XianYuFDK/STM32F407_Puzzle_Arm/硬件接线表.md

# STM32F407VGT6机械臂工程接线表

本文档依据当前工程 `D:\STM32\HAL\26` 的实际代码和 `26.ioc` 整理。

## 一、总引脚表

| 模块 | 功能 | STM32外设 | STM32引脚 | 有效方式/说明 |
|---|---|---|---|---|
| 舵机1 | 电磁铁末端旋转J1 | TIM1_CH2 | PE11 | 50Hz PWM，500~2500us对应0~180度 |
| 舵机2 | 腕部俯仰J2 | TIM1_CH3 | PE13 | 50Hz PWM，500~2500us对应0~180度 |
| 舵机3 | 肘部J3 | TIM1_CH4 | PE14 | 50Hz PWM，500~2500us对应0~180度 |
| 舵机4 | 肩部J4 | TIM8_CH1 | PC6 | 50Hz PWM，500~2500us对应0~180度 |
| 舵机5 | 底座旋转J5 | TIM8_CH2 | PC7 | 50Hz PWM，500~2500us对应0~180度 |
| K230视觉TX | STM32向视觉发送3A/3B/3C/AC等 | USART1_TX | PB6 | 115200，8N1，3.3V TTL |
| K230视觉RX | STM32接收52字节视觉帧 | USART1_RX | PB7 | DMA+空闲中断，3.3V TTL |
| 电脑调试TX | STM32向USB-TTL输出文本 | USART2_TX | PA2 | 115200，8N1，3.3V TTL |
| 电脑调试RX | STM32接收电脑文本命令 | USART2_RX | PA3 | DMA+空闲中断，3.3V TTL |
| 电磁铁继电器 | 控制电磁铁通断 | GPIO输出 | PD12 | 高电平闭合继电器 |
| 完成蜂鸣器 | 拼图完成提示 | GPIO输出 | PE9 | 高电平触发，响300ms后拉低 |
| 急停输入 | 常闭急停开关 | GPIO输入 | PD13 | 低电平有效；当前软件配置为关闭 |
| 按键1 | 启动任务1 | GPIO输入 | PE0 | 内部上拉，按下接GND |
| 按键2 | 启动任务2 | GPIO输入 | PE1 | 内部上拉，按下接GND |
| 按键3 | 启动任务3 | GPIO输入 | PE2 | 内部上拉，按下接GND |
| 按键4 | GOTO原点测试 | GPIO输入 | PE3 | 内部上拉，按下接GND |
| 按键5 | GOTO远点测试 | GPIO输入 | PE4 | 内部上拉，按下接GND |
| 按键6 | GOTO负Y测试点 | GPIO输入 | PE5 | 内部上拉，按下接GND |
| 按键7 | HOME | GPIO输入 | PE6 | 内部上拉，按下接GND |
| 按键8 | 软件强制停止 | GPIO输入 | PE7 | 内部上拉，按下接GND |
| 按键9 | 视觉校准 | GPIO输入 | PE8 | 内部上拉，按下接GND |
| 按键10 | 视觉辅助校准 | GPIO输入 | PE10 | 内部上拉，按下接GND |

## 二、5路舵机接线

| 新编号 | 机械作用 | PWM信号线 | 电源线 | 地线 |
|---|---|---|---|---|
| J1/舵机1 | 电磁铁末端旋转 | PE11 | 外部舵机电源正极 | 外部电源GND及STM32 GND |
| J2/舵机2 | 腕部俯仰 | PE13 | 外部舵机电源正极 | 外部电源GND及STM32 GND |
| J3/舵机3 | 肘部 | PE14 | 外部舵机电源正极 | 外部电源GND及STM32 GND |
| J4/舵机4 | 肩部 | PC6 | 外部舵机电源正极 | 外部电源GND及STM32 GND |
| J5/舵机5 | 底座旋转 | PC7 | 外部舵机电源正极 | 外部电源GND及STM32 GND |

舵机必须使用足够电流的独立电源，不能由STM32开发板的3.3V或小电流5V引脚直接供电。舵机电源GND、STM32 GND、K230 GND和USB-TTL GND必须共地。

## 三、K230视觉串口接线

| STM32端 | 连接K230端 |
|---|---|
| PB6 / USART1_TX | K230 RX |
| PB7 / USART1_RX | K230 TX |
| STM32 GND | K230 GND |

串口参数为115200、8位数据位、无校验、1位停止位、无硬件流控。TX与RX必须交叉连接。不要把5V串口电平直接接入STM32或K230。

## 四、电脑USB-TTL调试串口

| STM32端 | 连接USB-TTL端 |
|---|---|
| PA2 / USART2_TX | USB-TTL RX |
| PA3 / USART2_RX | USB-TTL TX |
| STM32 GND | USB-TTL GND |

USB-TTL应选择3.3V TTL逻辑电平，参数为115200、8N1。该串口使用ASCII文本命令。

## 五、按键接线和功能

所有按键采用内部上拉、低电平触发。每个按键一端连接对应GPIO，另一端连接GND，不需要外接3.3V。

| 按键 | GPIO | 当前功能 |
|---|---|---|
| KEY1 | PE0 | 启动任务1，向视觉发送0x3A |
| KEY2 | PE1 | 启动任务2，向视觉发送0x3B |
| KEY3 | PE2 | 启动任务3，向视觉发送0x3C，使用任务3独立速度参数 |
| KEY4 | PE3 | `GOTO 0 0 5 0 2000` |
| KEY5 | PE4 | `GOTO 210 0 5 0 3000` |
| KEY6 | PE5 | `GOTO 105 -70 1 0 3000` |
| KEY7 | PE6 | 3000ms回HOME |
| KEY8 | PE7 | 停止拼图、校准和运动，并关闭电磁铁 |
| KEY9 | PE8 | 向视觉发送0x3F，启动视觉校准 |
| KEY10 | PE10 | 向视觉发送0xAD，启动视觉辅助校准 |

接线示意：

```text
PE0  ---- KEY1  ---- GND
PE1  ---- KEY2  ---- GND
PE2  ---- KEY3  ---- GND
PE3  ---- KEY4  ---- GND
PE4  ---- KEY5  ---- GND
PE5  ---- KEY6  ---- GND
PE6  ---- KEY7  ---- GND
PE7  ---- KEY8  ---- GND
PE8  ---- KEY9  ---- GND
PE10 ---- KEY10 ---- GND
```

四脚轻触按键同一侧两个引脚通常内部相连，应从按键相对的两侧分别接GPIO和GND。

## 六、电磁铁继电器接线

控制端：

| STM32端 | 继电器模块端 |
|---|---|
| PD12 | IN/信号输入 |
| STM32 GND | 继电器模块GND |
| 模块要求的电源 | 继电器模块VCC |

负载端常用接法：

```text
电磁铁电源正极 ---- 继电器COM
继电器NO       ---- 电磁铁正极
电磁铁负极     ---- 电磁铁电源负极
```

PD12输出高电平时继电器闭合。若使用裸继电器，必须增加三极管/MOSFET驱动和续流二极管；不要由PD12直接驱动继电器线圈。

## 七、拼图完成蜂鸣器

| STM32端 | 高电平触发有源蜂鸣器模块 |
|---|---|
| PE9 | IN/信号输入 |
| STM32 GND | GND |
| 模块要求的电源 | VCC |

最后一块拼图放下并关闭电磁铁后，程序等待 `ARM_PUZZLE_DONE_DELAY_MS`，随后PE9输出高电平 `ARM_PUZZLE_DONE_PULSE_MS`，当前高电平持续时间为300ms。不能由PE9直接驱动大电流蜂鸣器或蜂鸣器线圈。

## 八、急停输入

预留接法：

```text
PD13 ---- 常闭急停开关 ---- GND
```

输入使用内部上拉，断开或按下方式必须与实际急停开关逻辑核对。当前 `ARM_ESTOP_ENABLED` 为0，PD13急停功能尚未启用；需要使用时应先改为1并重新编译。

## 九、SWD下载调试

| 调试器 | STM32 |
|---|---|
| SWDIO | PA13 |
| SWCLK | PA14 |
| GND | GND |
| 3.3V参考 | 3.3V |
| NRST（可选） | NRST |

## 十、供电和安全注意事项

1. STM32、K230、USB-TTL、舵机电源和继电器控制端必须共地。
2. 舵机应由独立大电流电源供电，并在舵机电源入口增加足够的电解电容。
3. 电磁铁电源与逻辑电源建议分开，电磁铁或继电器线圈两端需要反向续流保护。
4. 所有STM32 GPIO均按3.3V逻辑使用，不允许输入5V TTL信号。
5. PE9现在用于蜂鸣器，不再输出原夹爪舵机的TIM1_CH1 PWM。
6. 上电前检查PE11、PE13、PE14、PC6、PC7没有接错舵机，防止HOME动作造成撞机。
