XianYuFDK/STM32F407_Puzzle_Arm/STM32F407VGT6机械臂工程接线表.docx

硬件接线参考手册

STM32F407VGT6机械臂工程接线表

5路舵机 · K230视觉 · 串口调试 · 按键 · 电磁铁 · 蜂鸣器 · 急停

工程路径：D:\STM32\HAL\26

适用控制器：STM32F407VGT6（当前代码引脚定义）

串口参数：USART1/USART2：115200，8N1，3.3V TTL

更新日期：2026-08-01

接线总原则

舵机必须使用独立大电流电源。STM32、K230、USB-TTL、舵机电源和继电器控制端必须共地；所有信号按3.3V TTL逻辑连接。

# 一、总引脚表

模块 | 功能 | 外设 / 引脚 | 有效方式与说明
舵机1 | 电磁铁末端旋转J1 | TIM1_CH2 / PE11 | 50Hz PWM，500~2500us对应0~180°
舵机2 | 腕部俯仰J2 | TIM1_CH3 / PE13 | 50Hz PWM，500~2500us对应0~180°
舵机3 | 肘部J3 | TIM1_CH4 / PE14 | 50Hz PWM，500~2500us对应0~180°
舵机4 | 肩部J4 | TIM8_CH1 / PC6 | 50Hz PWM，500~2500us对应0~180°
舵机5 | 底座旋转J5 | TIM8_CH2 / PC7 | 50Hz PWM，500~2500us对应0~180°
K230视觉 | STM32发送/接收视觉数据 | USART1 / PB6、PB7 | 115200，8N1，DMA+空闲中断
电脑调试 | USB-TTL文本命令 | USART2 / PA2、PA3 | 115200，8N1，DMA+空闲中断
电磁铁 | 继电器控制 | GPIO / PD12 | 高电平闭合继电器
完成蜂鸣器 | 拼图完成提示 | GPIO / PE9 | 高电平触发，响300ms后拉低
急停预留 | 常闭急停输入 | GPIO / PD13 | 低电平有效；当前软件未启用
10个按键 | 任务、测试点和停止 | PE0~PE8、PE10 | 内部上拉，按下接GND

# 二、5路舵机接线

编号 | 机械作用 | PWM信号 | 电源 | 地线
J1 | 电磁铁末端旋转 | PE11 | 外部舵机电源正极 | 外部电源GND + STM32 GND
J2 | 腕部俯仰 | PE13 | 外部舵机电源正极 | 外部电源GND + STM32 GND
J3 | 肘部 | PE14 | 外部舵机电源正极 | 外部电源GND + STM32 GND
J4 | 肩部 | PC6 | 外部舵机电源正极 | 外部电源GND + STM32 GND
J5 | 底座旋转 | PC7 | 外部舵机电源正极 | 外部电源GND + STM32 GND

舵机供电警告

不要由STM32开发板的3.3V或小电流5V引脚直接给舵机供电。舵机堵转电流较大，应使用独立电源，并在电源入口配置足够容量的电解电容。

# 三、K230视觉串口（USART1）

STM32端 | K230端 | 说明
PB6 / USART1_TX | K230 RX | STM32向视觉发送3A、3B、3C、AC等单字节命令
PB7 / USART1_RX | K230 TX | STM32接收52字节视觉坐标帧
STM32 GND | K230 GND | 必须共地

串口交叉连接

TX必须连接对方RX，RX必须连接对方TX。参数为115200、8位数据、无校验、1位停止位、无硬件流控。

# 四、电脑USB-TTL调试串口（USART2）

STM32端 | USB-TTL端 | 说明
PA2 / USART2_TX | USB-TTL RX | STM32输出状态和文本应答
PA3 / USART2_RX | USB-TTL TX | 电脑发送GOTO、STATUS、TASK等ASCII命令
STM32 GND | USB-TTL GND | 必须共地

# 五、10个按键

所有按键均使用内部上拉、低电平触发：按键一端接对应GPIO，另一端统一接GND，不需要连接3.3V。

按键 | GPIO | 当前功能
KEY1 | PE0 | 启动任务1，向视觉发送0x3A
KEY2 | PE1 | 启动任务2，向视觉发送0x3B
KEY3 | PE2 | 启动任务3，发送0x3C，并使用任务3独立速度参数
KEY4 | PE3 | GOTO 0 0 5 0 2000
KEY5 | PE4 | GOTO 210 0 5 0 3000
KEY6 | PE5 | GOTO 105 -70 1 0 3000
KEY7 | PE6 | 机械臂用3000ms回到HOME
KEY8 | PE7 | 软件停止拼图、校准和运动，并关闭电磁铁
KEY9 | PE8 | 向视觉发送0x3F，启动视觉校准
KEY10 | PE10 | 向视觉发送0xAD，启动视觉辅助校准

# 六、电磁铁继电器

STM32端 | 继电器模块端 | 功能
PD12 | IN | 高电平使继电器闭合
STM32 GND | GND | 控制端共地
模块要求的电源 | VCC | 按继电器模块额定电压供电

负载端推荐：电磁铁电源正极 → COM；NO → 电磁铁正极；电磁铁负极 → 电磁铁电源负极。

继电器驱动警告

若使用裸继电器，必须增加三极管或MOSFET驱动及续流二极管，禁止使用PD12直接驱动继电器线圈。

# 七、拼图完成蜂鸣器

STM32端 | 蜂鸣器模块端 | 说明
PE9 | IN | 高电平触发有源蜂鸣器
STM32 GND | GND | 必须共地
模块要求的电源 | VCC | 按蜂鸣器模块额定电压供电

当前流程：最后一块放下并关闭电磁铁 → 等待300ms → PE9拉高300ms → PE9自动恢复低电平。

蜂鸣器类型

应使用高电平触发的有源蜂鸣器模块或MOSFET驱动板，不能由PE9直接驱动大电流蜂鸣器或线圈。

# 八、急停输入（预留）

预留接法：PD13 → 常闭急停开关 → GND。输入采用内部上拉、低电平有效。

当前状态

ARM_ESTOP_ENABLED 当前为0，PD13急停功能尚未启用。需要使用时，先把该宏改为1，确认常闭开关逻辑，再重新编译烧录。

# 九、SWD下载调试

调试器端 | STM32端 | 说明
SWDIO | PA13 | 数据线
SWCLK | PA14 | 时钟线
GND | GND | 共地
3.3V参考 | 3.3V | 电平参考，不建议由调试器给整机大负载供电
NRST（可选） | NRST | 复位线

# 十、上电前检查清单

序号 | 检查要求
1 | 确认PE11、PE13、PE14、PC6、PC7分别连接J1~J5，避免HOME动作撞机。
2 | 确认舵机由独立大电流电源供电，且与STM32共地。
3 | 确认K230和USB-TTL均为3.3V TTL，TX/RX交叉连接。
4 | 确认PD12只接继电器模块输入，不直接驱动线圈。
5 | 确认PE9只接高电平触发蜂鸣器模块输入。
6 | 首次上电时保持机械臂工作空间无障碍，并准备使用KEY8停止。

机械臂工程接线参考 STM32F407VGT6
