XianYuFDK/STM32F407_Puzzle_Arm/Core/Inc/main.h

#define PUZZLE_DONE_Pin GPIO_PIN_9
#define PUZZLE_DONE_GPIO_Port GPIOE
#define MAGNET_CTRL_Pin GPIO_PIN_12
#define MAGNET_CTRL_GPIO_Port GPIOD
