XianYuFDK/STM32F407_Puzzle_Arm/BSP/Inc/bsp_puzzle_indicator.h

#ifndef BSP_PUZZLE_INDICATOR_H
#define BSP_PUZZLE_INDICATOR_H

#include <stdbool.h>

void BspPuzzleIndicator_Init(void);
void BspPuzzleIndicator_Set(bool enabled);

#endif /* BSP_PUZZLE_INDICATOR_H */
