XianYuFDK/STM32F407_Puzzle_Arm/(commit log)

2026-11-09 feat: 初始化 2026 电赛 E 题拼图机械臂固件
    - STM32F407VET6 + FreeRTOS，五轴舵机 + 电磁铁执行机构
    - USART1 视觉 52 字节计划协议（校验/去重/0xAC）与 USART2 文本调试 CLI
    - 解析逆运动学、整套预解算、逐片抓取-搬运-旋转-放置状态机
    - A4 六点校准、按键面板、运动插值、STOP/超时/电磁铁保护
    - 中文 README、软件架构说明、硬件接线表与 PC 端调试脚本
2026-11-09 docs: 修正 README 用词并校验文档内链
2026-11-09 chore: 精简工程依赖，仅保留构建所需文件
    - 移除 CMSIS DSP/NN/RTOS/DAP、旧版 Core 副本与其余 STM32F4 型号头
    - HAL Src 仅保留工程实际编译的 16 个模块，删除 78 个未引用源文件
    - FreeRTOS 仅保留 heap_4、必需内核源码与 CM4F 端口
    - 删除报告渲染 PNG，保留 PDF
    - README 补充 9.4 依赖范围与裁剪后扩展方法
